dm-urievich/winder/photo/1448128174265212136272.jpg

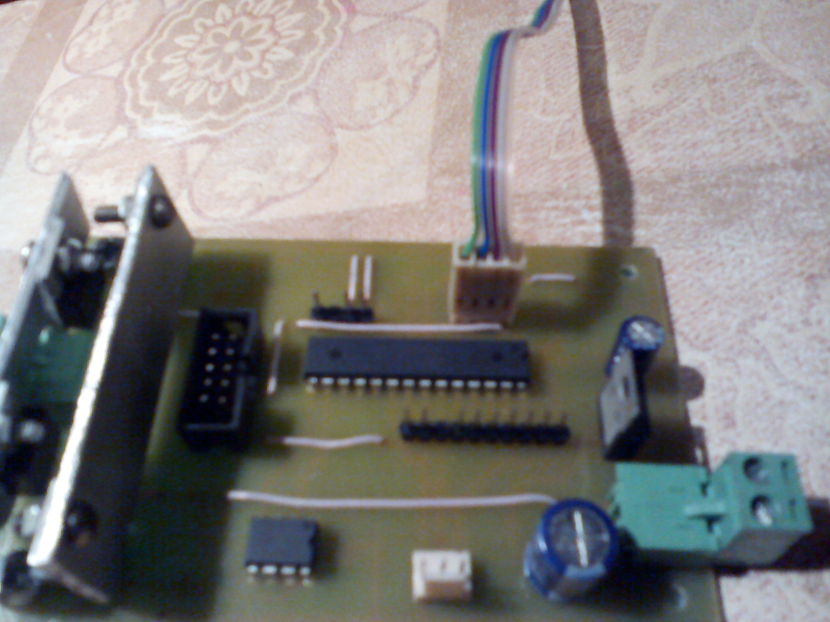
photo/1448128174265212136272.jpg
