dm-urievich/winder/photo/IMG_20151101_202608_1.jpg

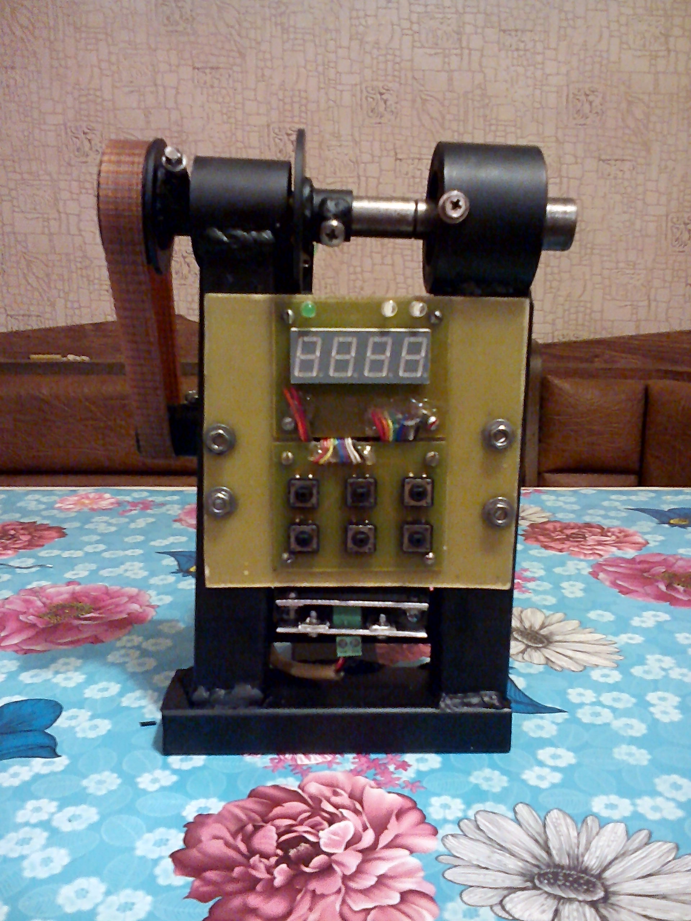
photo/IMG_20151101_202608_1.jpg
