dm-urievich/winder/photo/1448128219867-2031490154.jpg

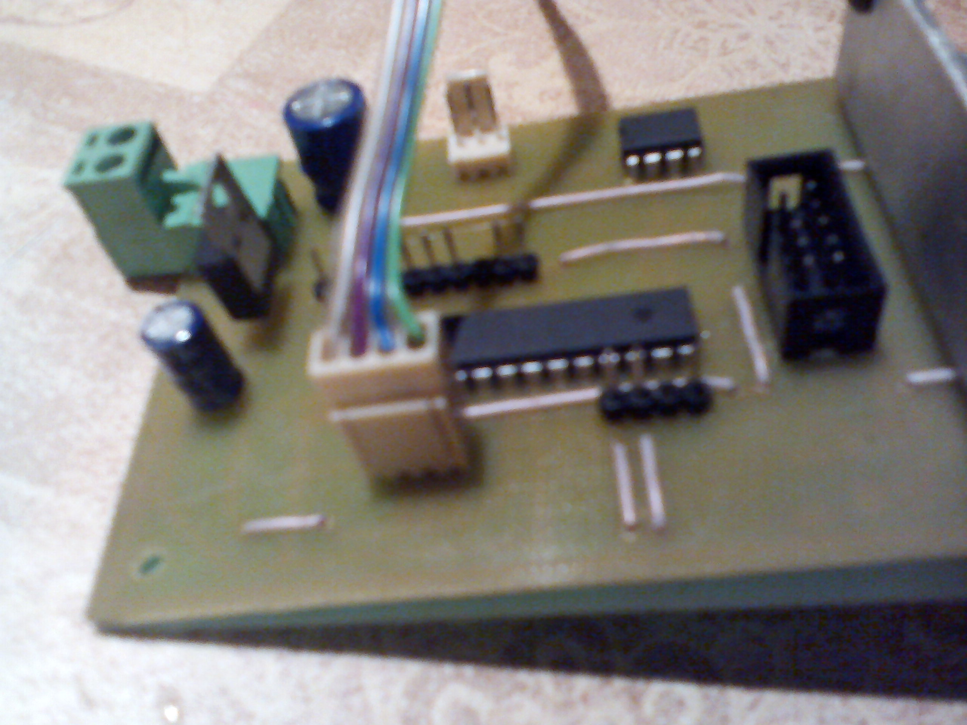
photo/1448128219867-2031490154.jpg
