dm-urievich/winder/photo/DSC_0050.JPG

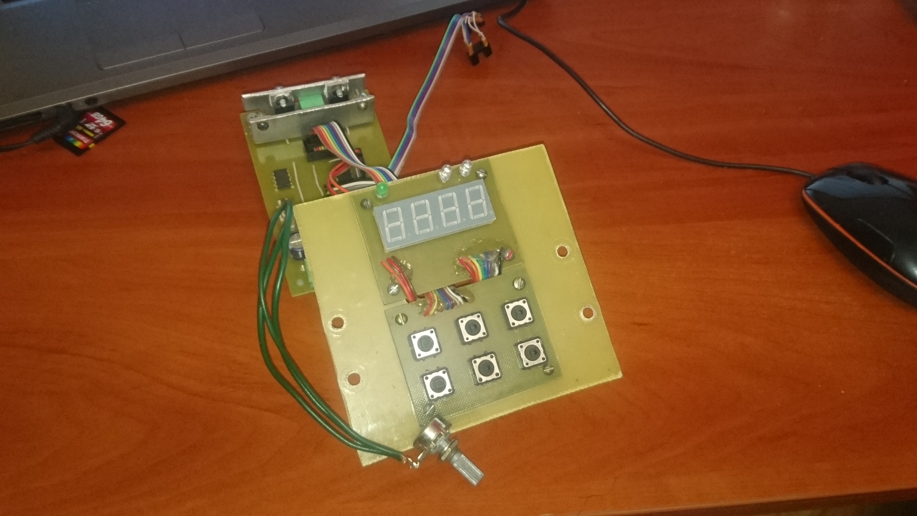
photo/DSC_0050.JPG
