dm-urievich/winder/photo/DSCN9139.JPG

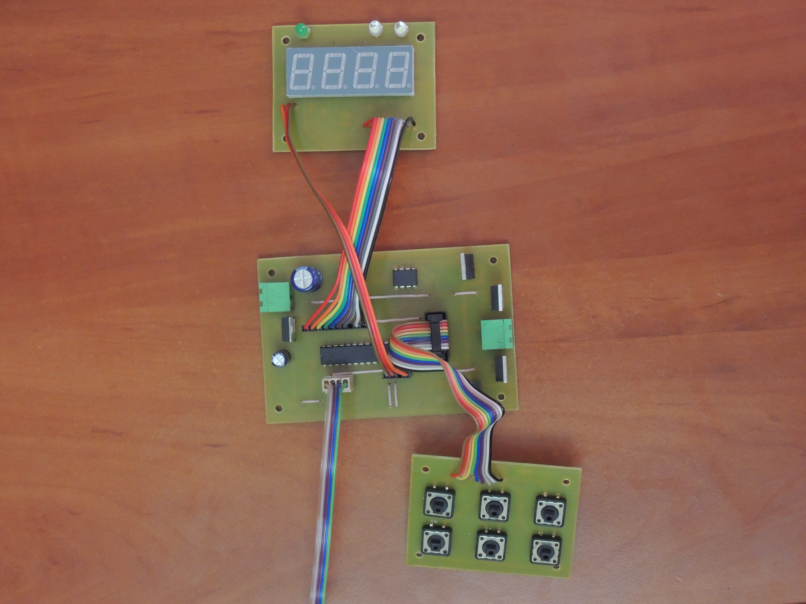
photo/DSCN9139.JPG
