dm-urievich/winder/schematic/schematic.png

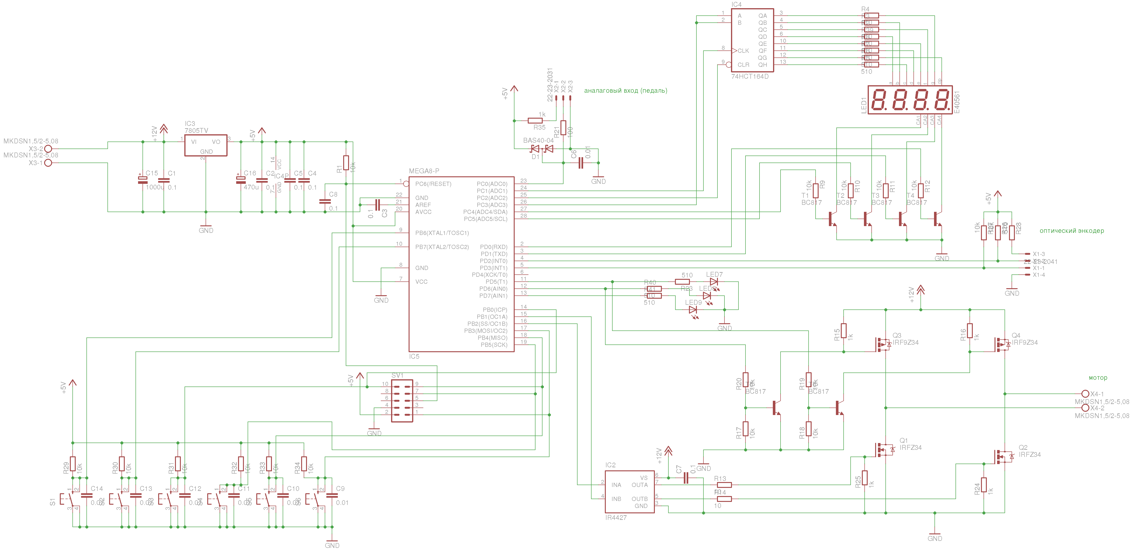
schematic/schematic.png
