dm-urievich/winder/schematic/scheme.pdf

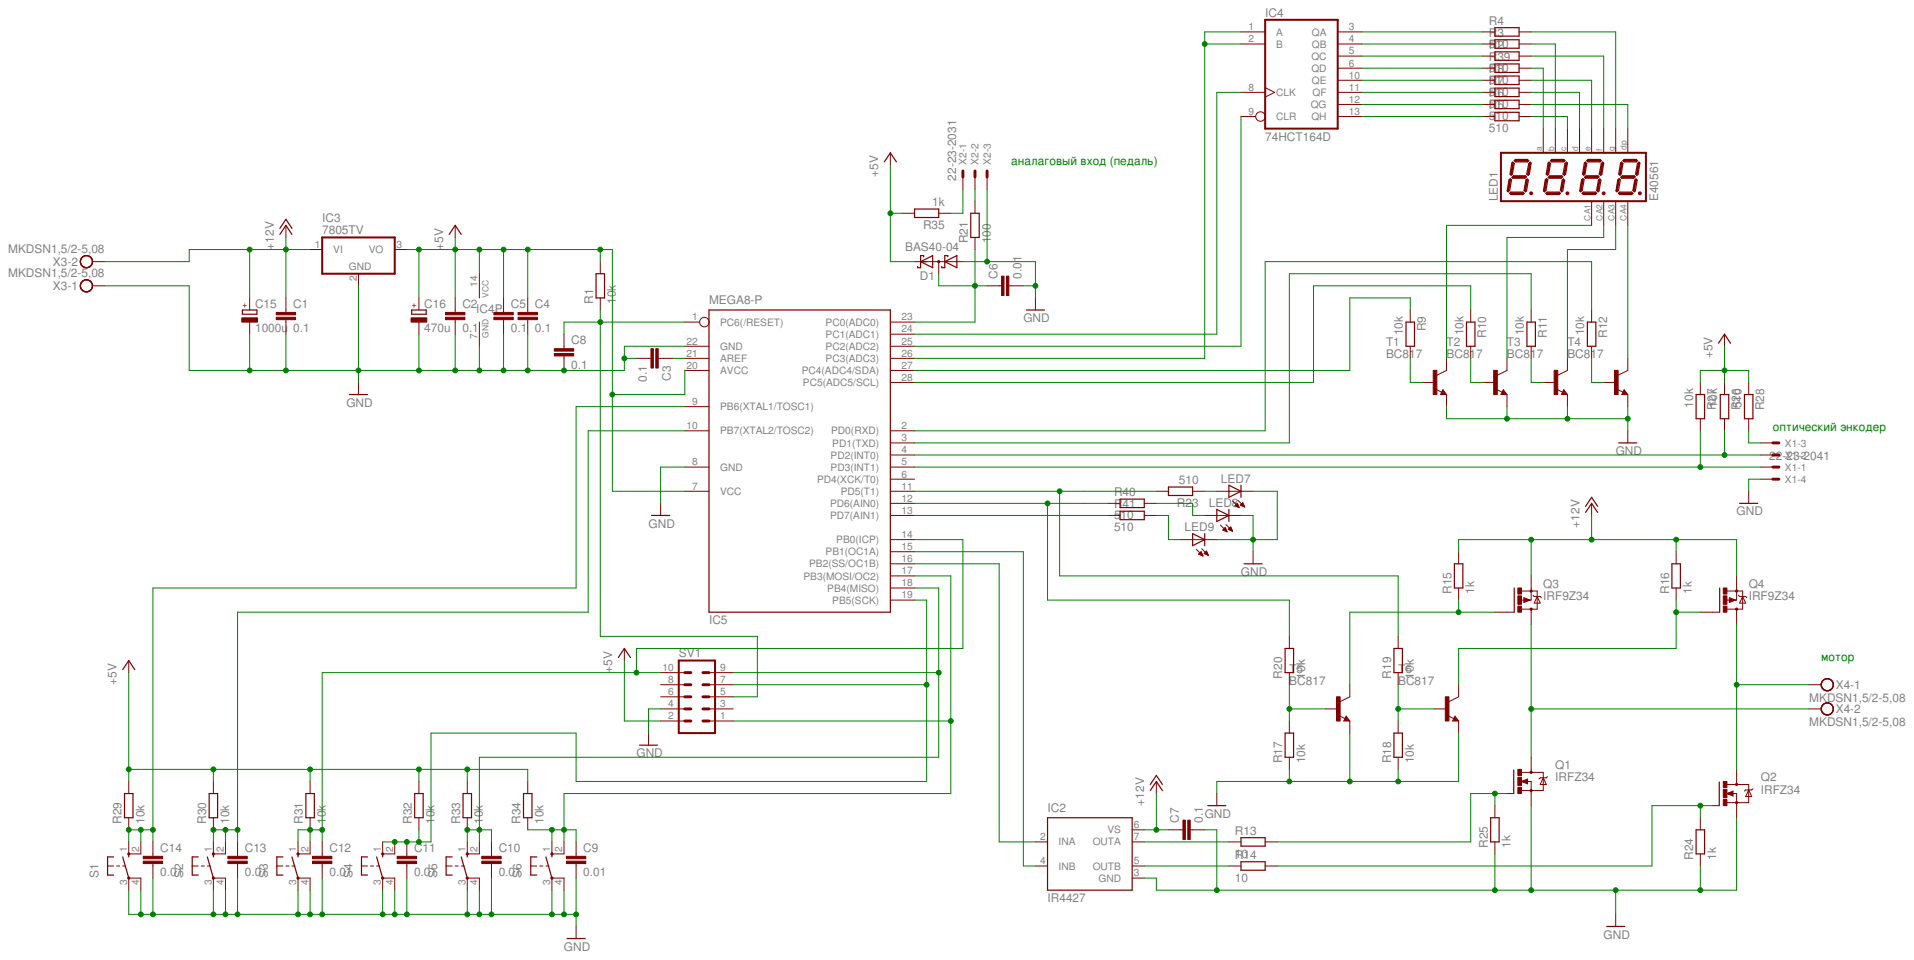
[picture p7: page 1]

510 R2 5 QD
510 R8 10 QF
