dm-urievich/winder/schematic/winder.brd

## EAGLE design schematic/winder.brd (2015-10-11)

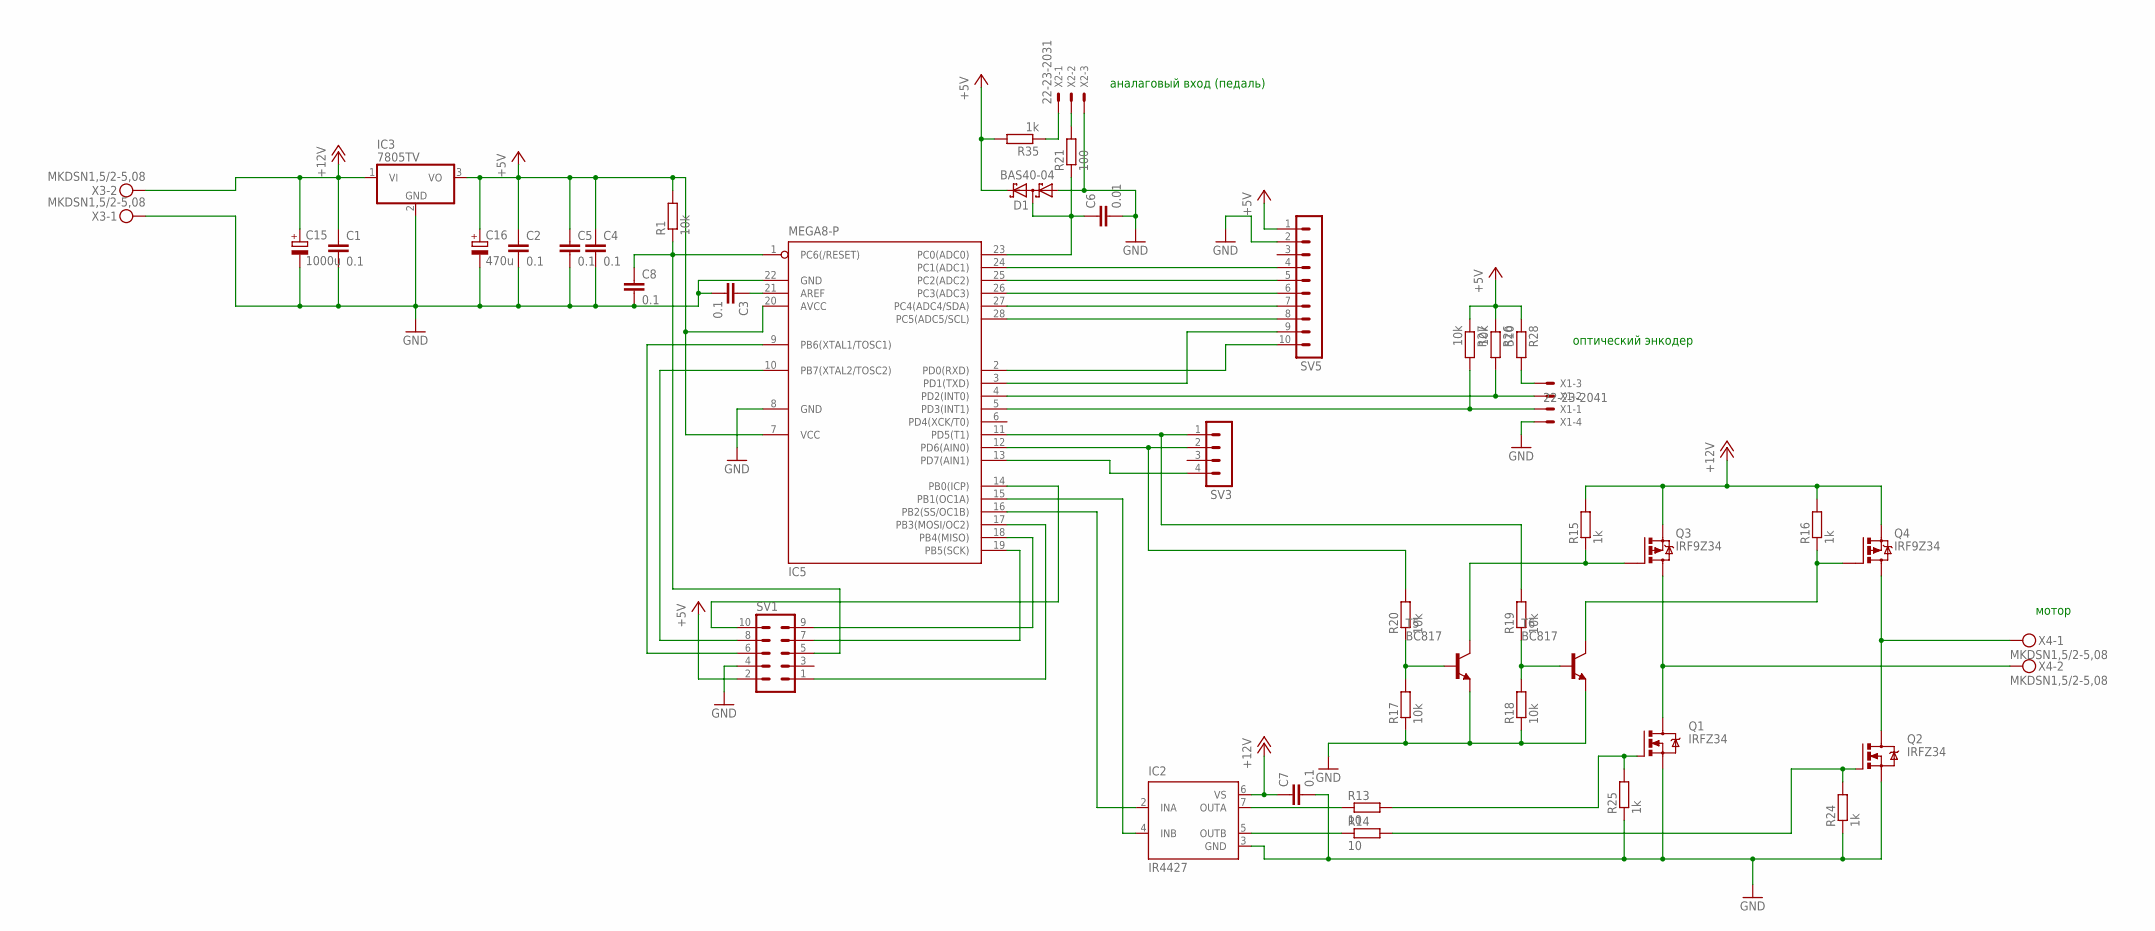
[picture p8: schematic winder.sch]

Parts:
C1, C2, C3, C4, C5, C7, C8: 0.1; C0805
C6: 0.01; C0805
C15: 1000u; E3,5-10
C16: 470u; E3,5-10
D1: BAS40-04; SOT23
IC2: IR4427; DIL08
IC3: 7805TV; TO220V
IC5: MEGA8-P; DIL28-3
Q1, Q2: IRFZ34; TO220BV
Q3, Q4: IRF9Z34; TO220BV
R1, R17, R18, R19, R20, R26, R27: 10k; R0805
R13, R14: 10; R0805
R15, R16, R24, R25, R35: 1k; R0805
R21: 100; R0805
R28: 510; R0805
SV1: ML10
SV3: MA04-1
SV5: MA10-1
T5, T6: BC817; SOT23-BEC
X1: 22-23-2041
X2: 22-23-2031
X3, X4: MKDSN1,5/2-5,08

Connections:
+5V: C2.1, C4.1, C5.1, C16.+, D1.2 (C2), IC3.3 (VO), IC5.7 (VCC), IC5.20 (AVCC), R1.2, R26.1, R27.1, R28.1, R35.2, SV1.2, SV5.1
+12V: C1.1, C7.1, C15.+, IC2.6 (VS), IC3.1 (VI), Q3.S, Q4.S, R15.2, R16.2, X3.2
GND: C1.2, C2.2, C3.2, C4.2, C5.2, C6.2, C7.2, C8.2, C15.-, C16.-, D1.1 (A1), IC2.3 (GND), IC3.2 (GND), IC5.8 (GND), IC5.22 (GND), Q1.S, Q2.S, R17.1, R18.1, R24.1, R25.1, SV1.4, SV5.2, T5.E, T6.E, X1.4, X2.3, X3.1
unnamed: IC5.13 (PD7(AIN1)), SV3.4
unnamed: R28.2, X1.3
unnamed: C6.1, D1.3 (C1A2), IC5.23 (PC0(ADC0)), R21.1
unnamed: IC5.14 (PB0(ICP)), SV1.10
unnamed: IC5.5 (PD3(INT1)), R27.2, X1.1
unnamed: IC5.4 (PD2(INT0)), R26.2, X1.2
unnamed: IC5.28 (PC5(ADC5/SCL)), SV5.8
unnamed: IC5.27 (PC4(ADC4/SDA)), SV5.7
unnamed: Q4.G, R16.1, T6.C
unnamed: Q3.G, R15.1, T5.C
unnamed: R17.2, R20.1, T5.B
unnamed: R18.2, R19.1, T6.B
unnamed: R21.2, X2.2
unnamed: Q1.D, Q3.D, X4.2
unnamed: Q2.D, Q4.D, X4.1
unnamed: Q1.G, R13.2, R25.2
unnamed: Q2.G, R14.2, R24.2
unnamed: IC2.7 (OUTA), R13.1
unnamed: IC2.5 (OUTB), R14.1
unnamed: IC2.4 (INB), IC5.15 (PB1(OC1A))
unnamed: IC5.10 (PB7(XTAL2/TOSC2)), SV1.8
unnamed: IC5.17 (PB3(MOSI/OC2)), SV1.1
unnamed: C8.1, IC5.1 (PC6(/RESET)), R1.1, SV1.5
unnamed: R35.1, X2.1
unnamed: IC5.19 (PB5(SCK)), SV1.7
unnamed: IC5.18 (PB4(MISO)), SV1.9
unnamed: C3.1, IC5.21 (AREF)
unnamed: IC5.11 (PD5(T1)), R19.2, SV3.1
unnamed: IC5.12 (PD6(AIN0)), R20.2, SV3.2
unnamed: IC5.26 (PC3(ADC3)), SV5.6
unnamed: IC5.25 (PC2(ADC2)), SV5.5
unnamed: IC5.3 (PD1(TXD)), SV5.9
unnamed: IC5.9 (PB6(XTAL1/TOSC1)), SV1.6
unnamed: IC5.2 (PD0(RXD)), SV5.10
unnamed: IC5.24 (PC1(ADC1)), SV5.4
unnamed: IC2.2 (INA), IC5.16 (PB2(SS/OC1B))

Notes on the sheet:
оптический энкодер
аналаговый вход (педаль)
мотор

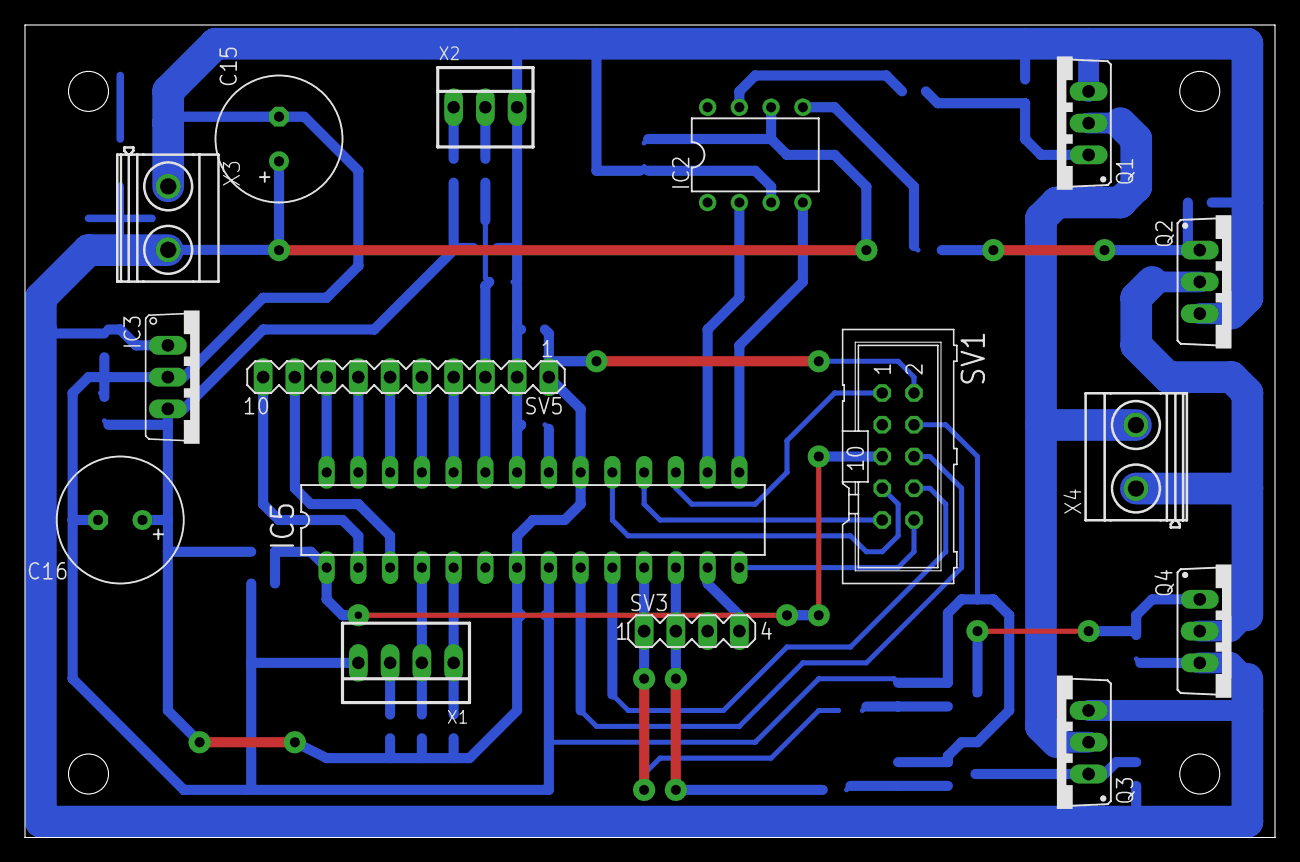
[picture p9: board winder.brd from above]

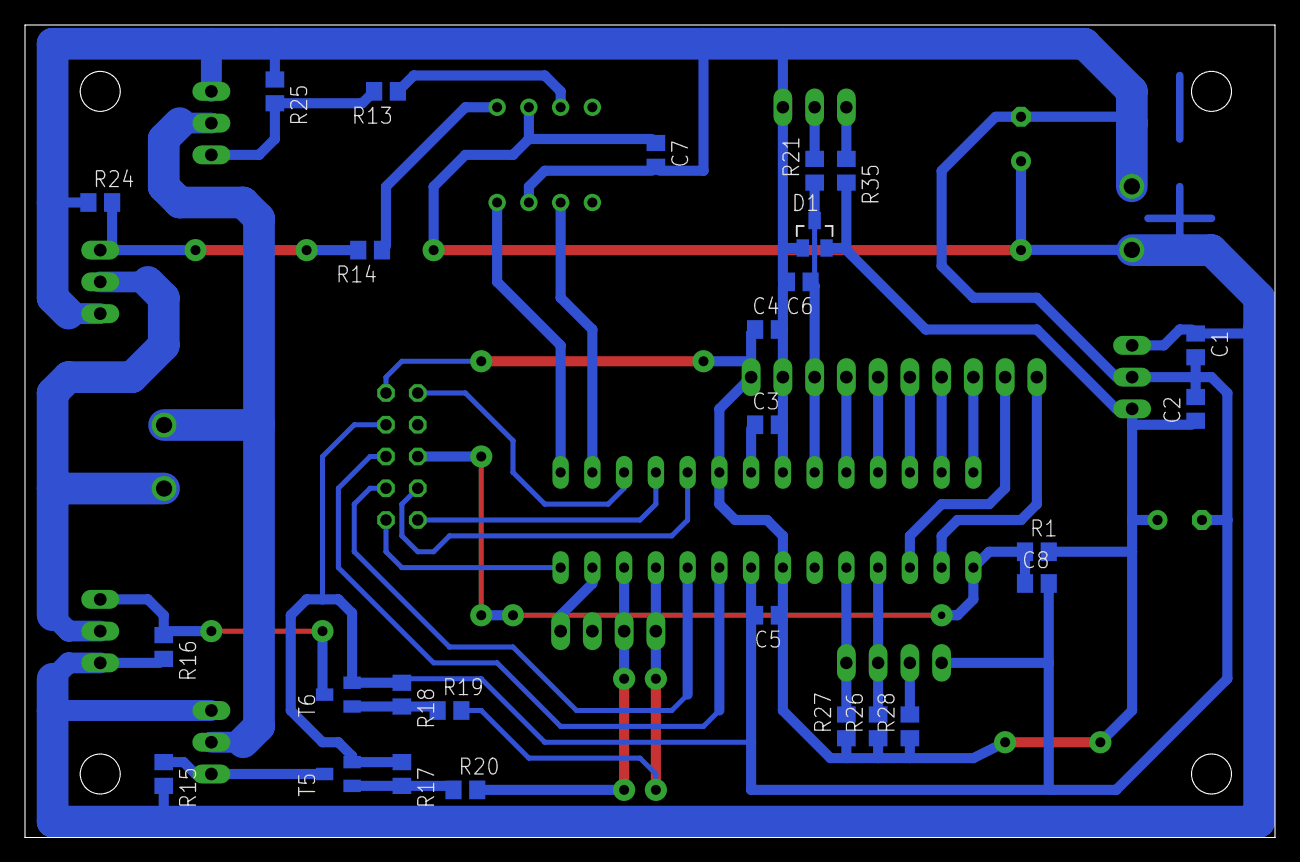
[picture p10: board winder.brd from below]

Board: 2 copper layers, 100.0 x 65.0 mm, 43 parts (27 on the bottom side), 39 nets.
