dm-urievich/winder/schematic/buttons.brd

## EAGLE design schematic/buttons.brd (2015-10-11)

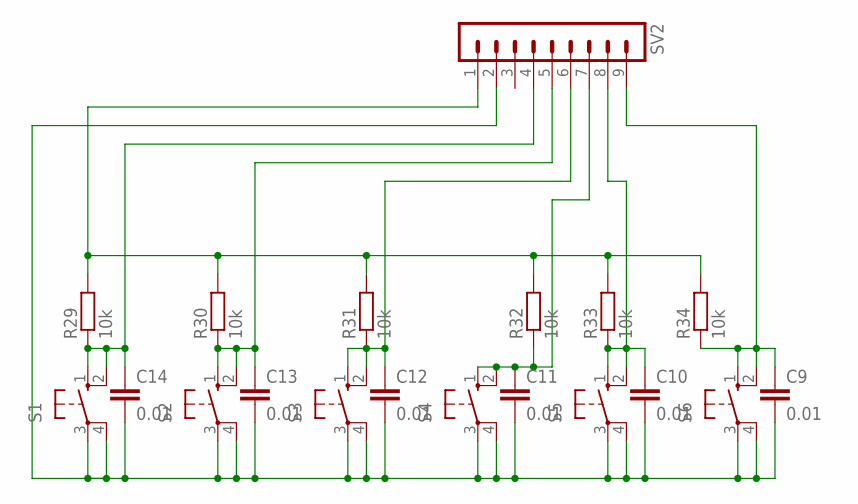
[picture p11: schematic buttons.sch]

Parts:
C9, C10, C11, C12, C13, C14: 0.01; C0805
R29, R30, R31, R32, R33, R34: 10k; R0805
S1, S2, S3, S4, S5, S6: 40-XX; B3F-40XX
SV2: MA09-1

Connections:
unnamed: C13.1, R30.1, S2.1 (S), S2.2 (S1), SV2.5
unnamed: C11.1, R32.1, S4.1 (S), S4.2 (S1), SV2.7
unnamed: C10.1, R33.1, S5.1 (S), S5.2 (S1), SV2.8
unnamed: C14.1, R29.1, S1.1 (S), S1.2 (S1), SV2.4
unnamed: C9.1, R34.1, S6.1 (S), S6.2 (S1), SV2.9
unnamed: R29.2, R30.2, R31.2, R32.2, R33.2, R34.2, SV2.1
unnamed: C9.2, C10.2, C11.2, C12.2, C13.2, C14.2, S1.3, S1.4 (P1), S2.3, S2.4 (P1), S3.3, S3.4 (P1), S4.3, S4.4 (P1), S5.3, S5.4 (P1), S6.3, S6.4 (P1), SV2.2
unnamed: C12.1, R31.1, S3.1 (S), S3.2 (S1), SV2.6

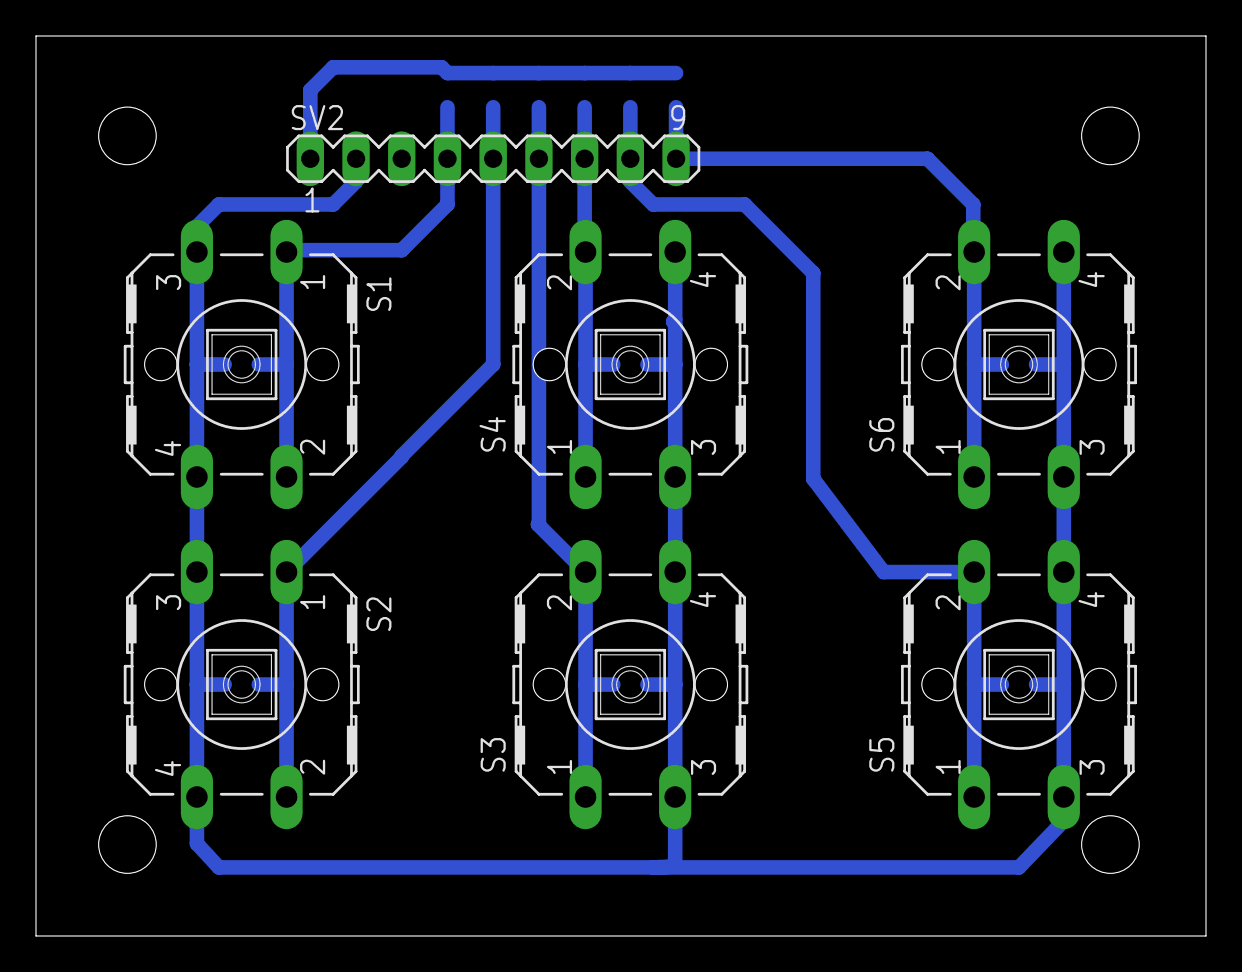
[picture p12: board buttons.brd from above]

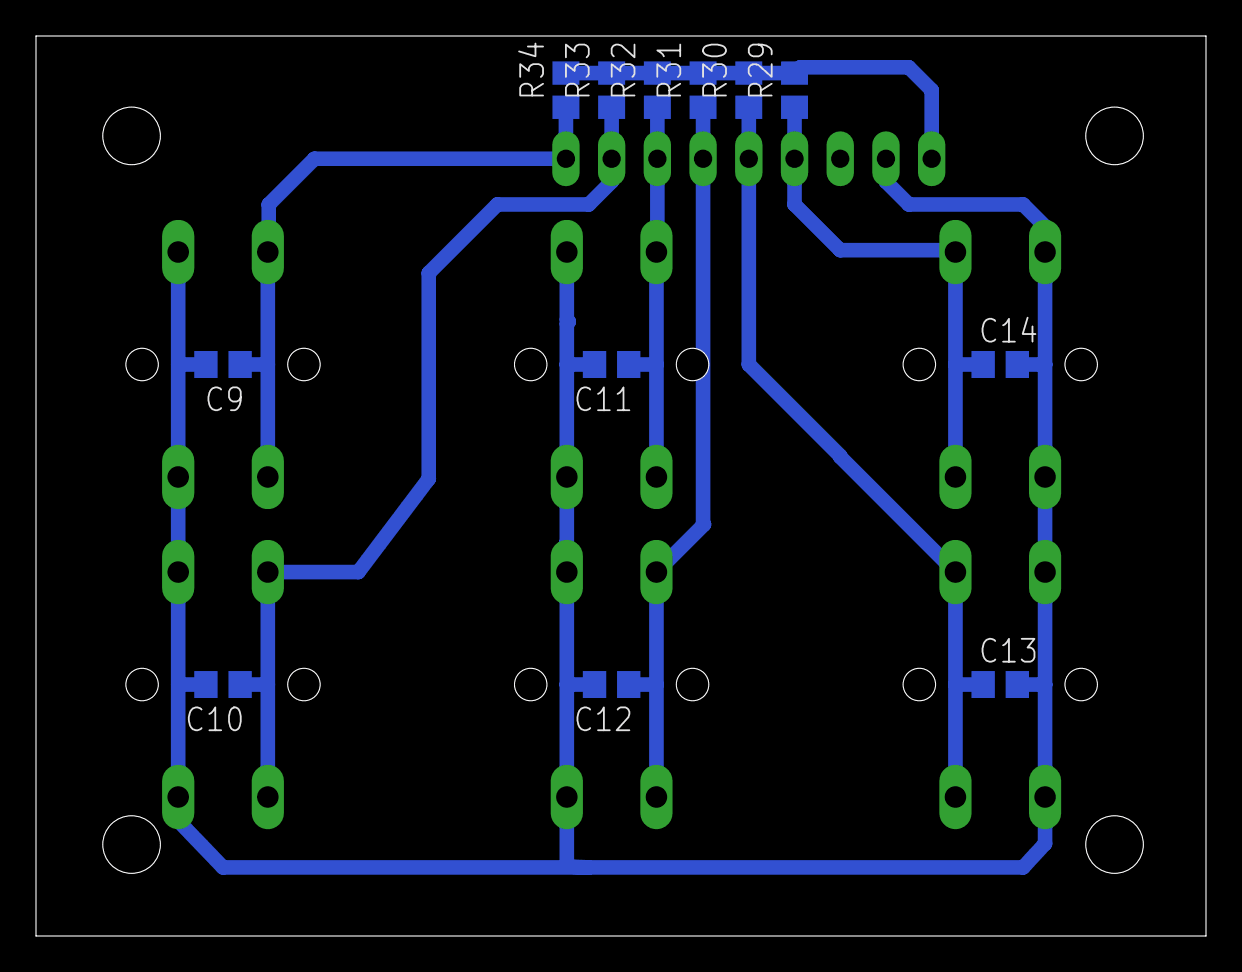
[picture p13: board buttons.brd from below]

Board: 2 copper layers, 65.0 x 50.0 mm, 19 parts (12 on the bottom side), 8 nets.
