dm-urievich/winder/schematic/indicator.brd

## EAGLE design schematic/indicator.brd (2015-10-11)

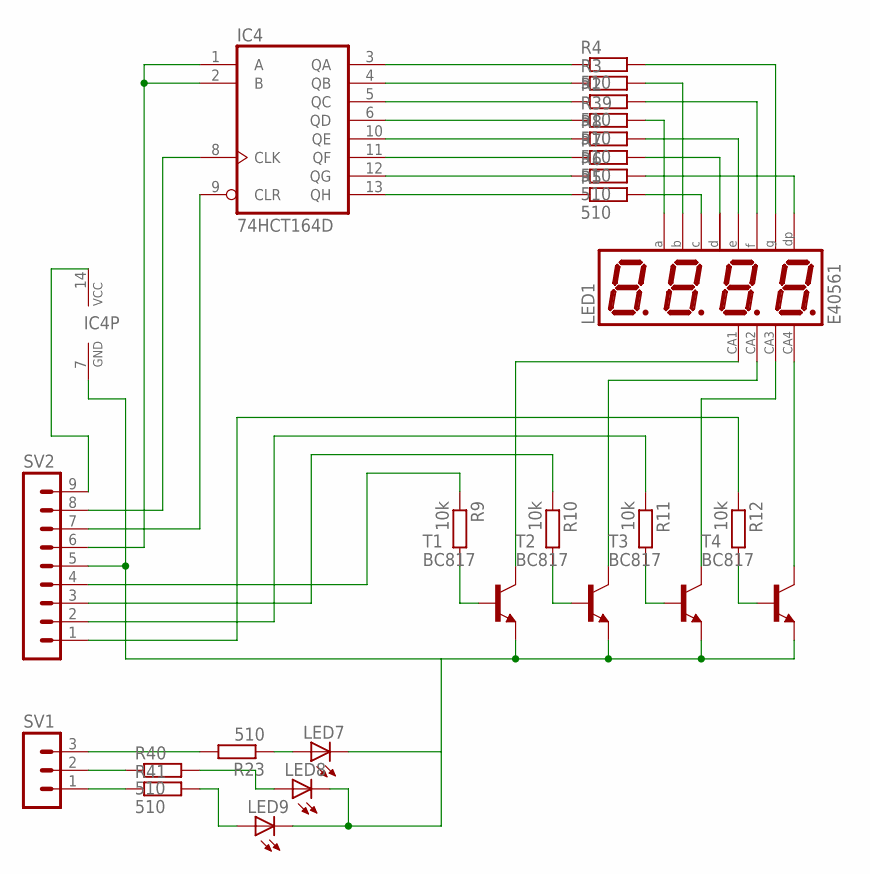
[picture p14: schematic indicator.sch]

Parts:
IC4: 74HCT164D; SO14
LED1: E40561; BX56-12
LED7, LED8, LED9: LED5MM
R2, R4, R5, R6, R7, R8, R23, R39, R40, R41: 510; R0805
R3: R-EU_R0805; R0805
R9, R10, R11, R12: 10k; R0805
SV1: MA03-1
SV2: MA09-1
T1, T2, T3, T4: BC817; SOT23-BEC

Connections:
unnamed: R9.2, T1.B
unnamed: R10.2, T2.B
unnamed: R11.2, T3.B
unnamed: R12.2, T4.B
unnamed: LED1.6 (CA), T4.C
unnamed: LED1.8 (CA), T3.C
unnamed: LED1.9 (CA), T2.C
unnamed: LED1.12 (CA), T1.C
unnamed: R40.1, SV1.2
unnamed: LED1.1 (E), R8.2
unnamed: IC4.6 (QD), R39.1
unnamed: IC4.5 (QC), R2.1
unnamed: IC4.4 (QB), R3.1
unnamed: IC4.3 (QA), R4.1
unnamed: IC4.10 (QE), R8.1
unnamed: IC4.11 (QF), R7.1
unnamed: LED1.2 (D), R7.2
unnamed: LED1.3 (DP), R6.2
unnamed: LED1.4 (C), R5.2
unnamed: LED1.5 (G), R4.2
unnamed: LED1.7 (B), R3.2
unnamed: LED1.10 (F), R2.2
unnamed: LED1.11 (A), R39.2
unnamed: R41.1, SV1.1
unnamed: IC4.12 (QG), R6.1
unnamed: R12.1, SV2.1
unnamed: IC4.13 (QH), R5.1
unnamed: IC4.8 (CLK), SV2.8
unnamed: IC4.9 (CLR), SV2.7
unnamed: IC4.7 (GND), LED7.K (C), LED8.K (C), LED9.K (C), SV2.5, T1.E, T2.E, T3.E, T4.E
unnamed: LED7.A, R23.1
unnamed: IC4.1 (A), IC4.2 (B), SV2.6
unnamed: LED8.A, R40.2
unnamed: LED9.A, R41.2
unnamed: R10.1, SV2.3
unnamed: R9.1, SV2.4
unnamed: R11.1, SV2.2
unnamed: IC4.14 (VCC), SV2.9
unnamed: R23.2, SV1.3

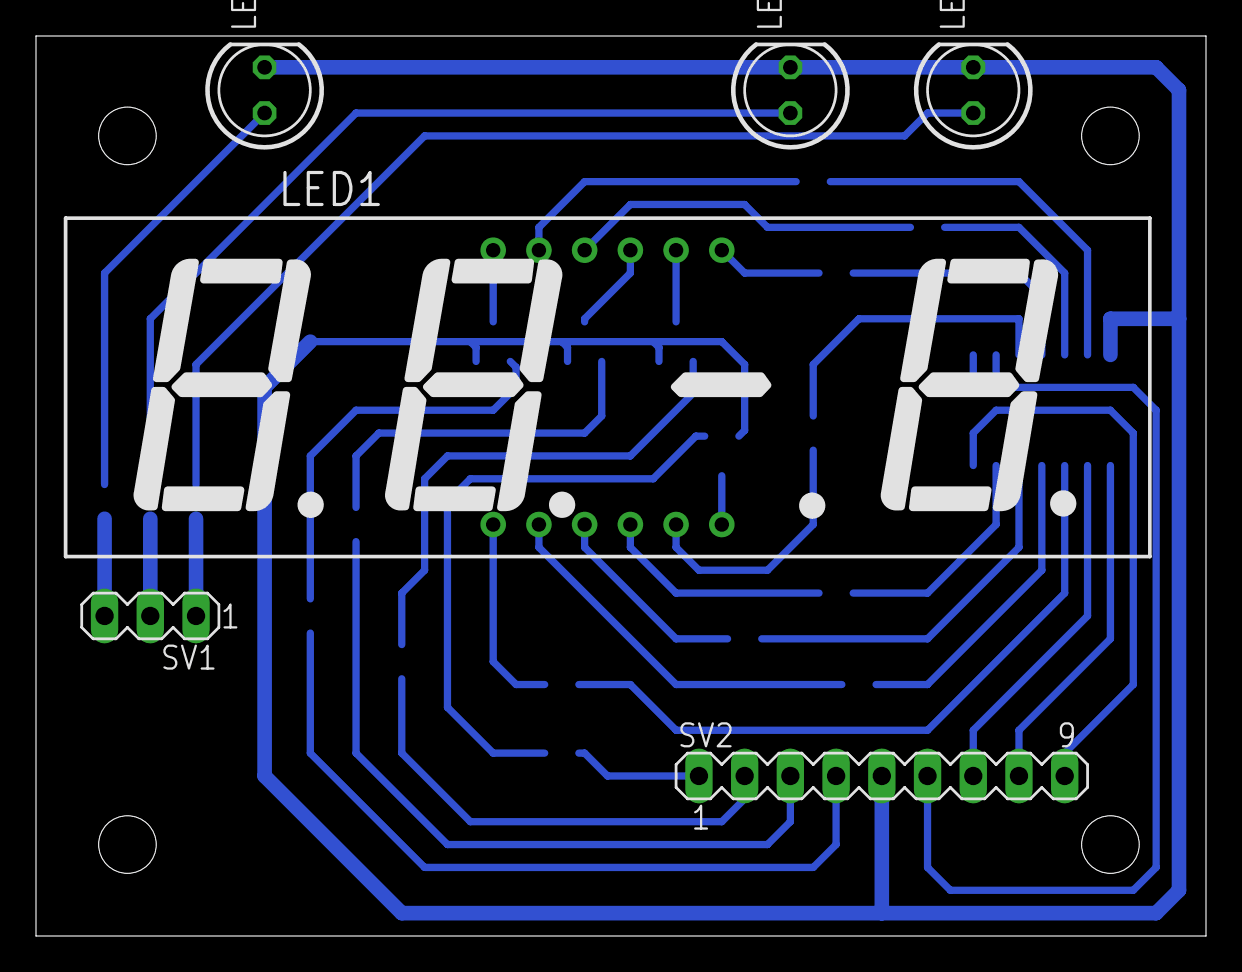
[picture p15: board indicator.brd from above]

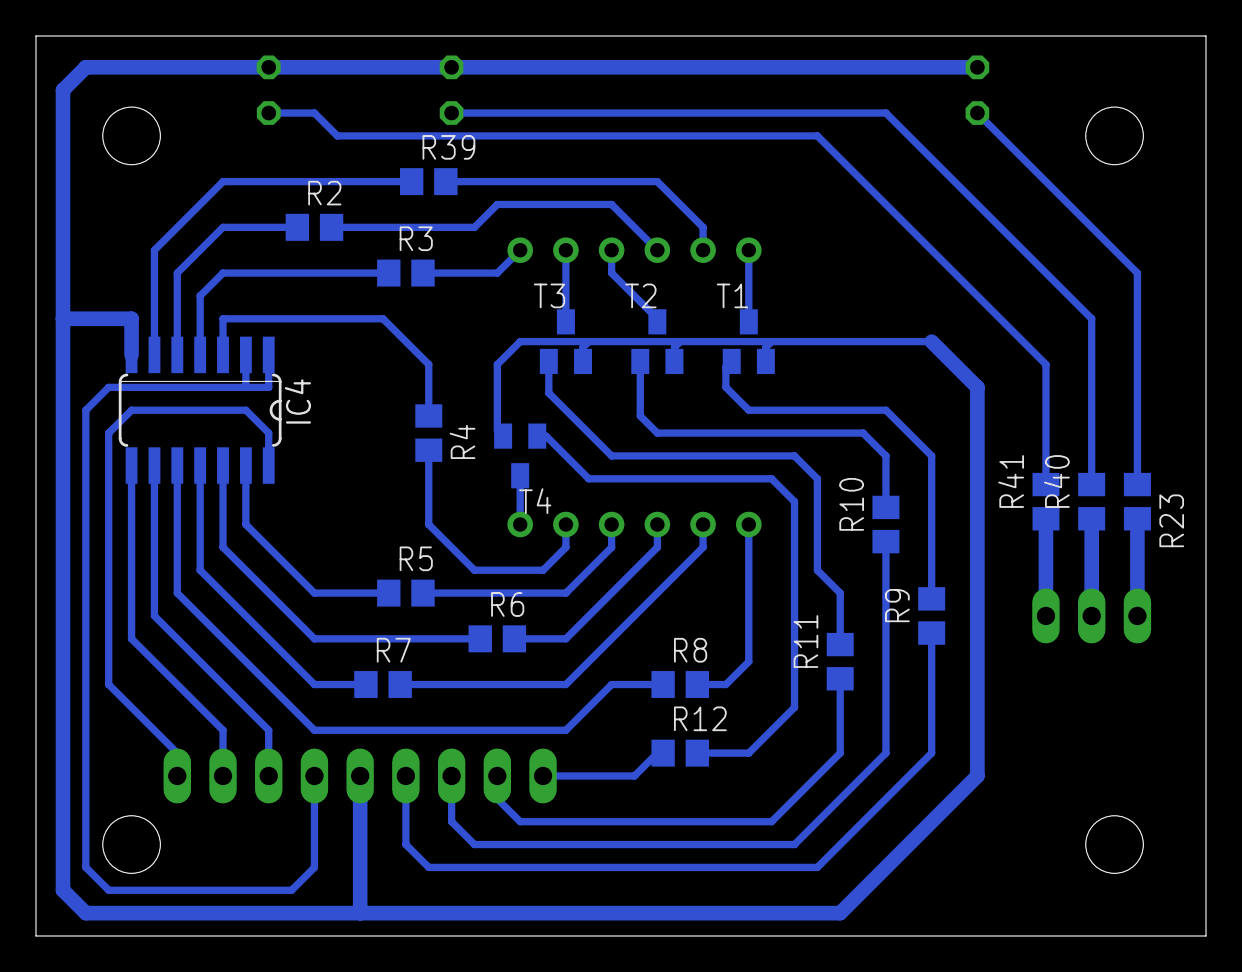
[picture p16: board indicator.brd from below]

Board: 2 copper layers, 65.0 x 50.0 mm, 26 parts (20 on the bottom side), 39 nets.
