dm-urievich/winder/(commit log)

2015-10-11 add schematic
    [buttons.brd, buttons.sch, indicator.brd, indicator.sch, winder.brd, winder.sch]
2015-10-11 saving settings to eeprom, encoder already works, indicator bugfix
    [indicator.c, main.c, main.h]
2015-10-11 add full schematic in one sheet
    [scheme.sch]
2015-11-08 second version, fix bug with editing speed end env_value in STOP, fix bug with reverse rotation, rework indication
    [main.c, main.h]
2016-02-27 add photo device
